VojtaKudela/BPC-DE1-topic_4/Documentation/Schematics/matrix_control.png

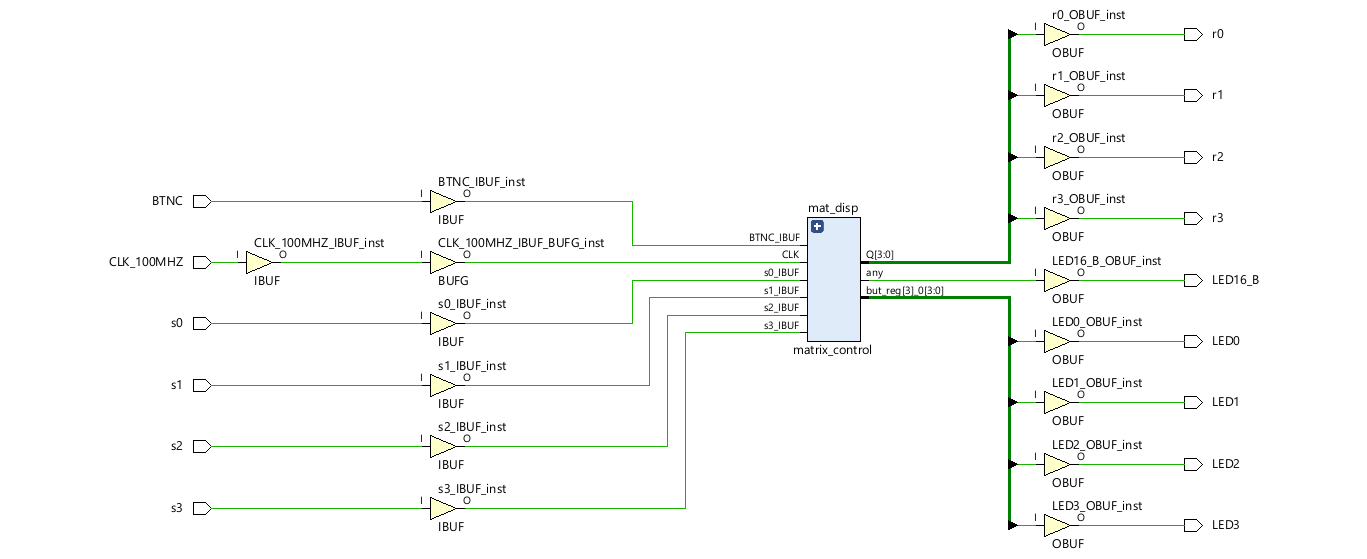
Documentation/Schematics/matrix_control.png
