VojtaKudela/BPC-DE1-topic_4/Picture/ForReadMe/LED.png

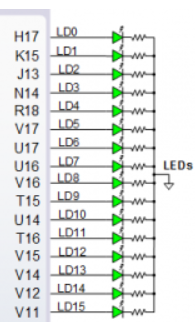
Picture/ForReadMe/LED.png
