VojtaKudela/BPC-DE1-topic_4/Picture/ForReadMe/PWM_mod.png

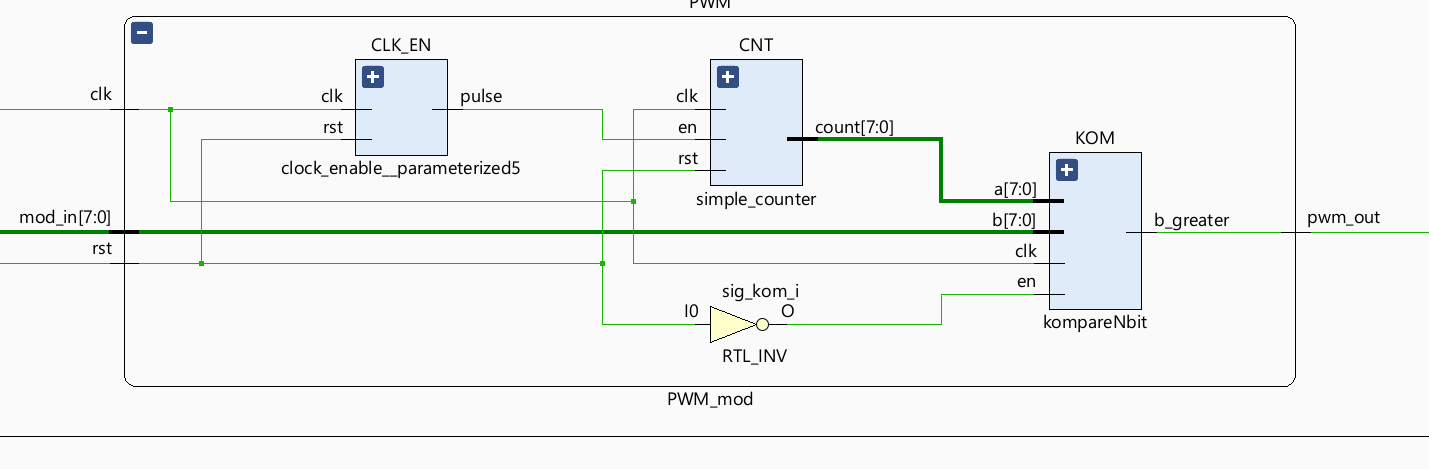
Picture/ForReadMe/PWM_mod.png
