VojtaKudela/BPC-DE1-topic_4/Picture/PředlohyKProgramování/bin2seg_1.jpg

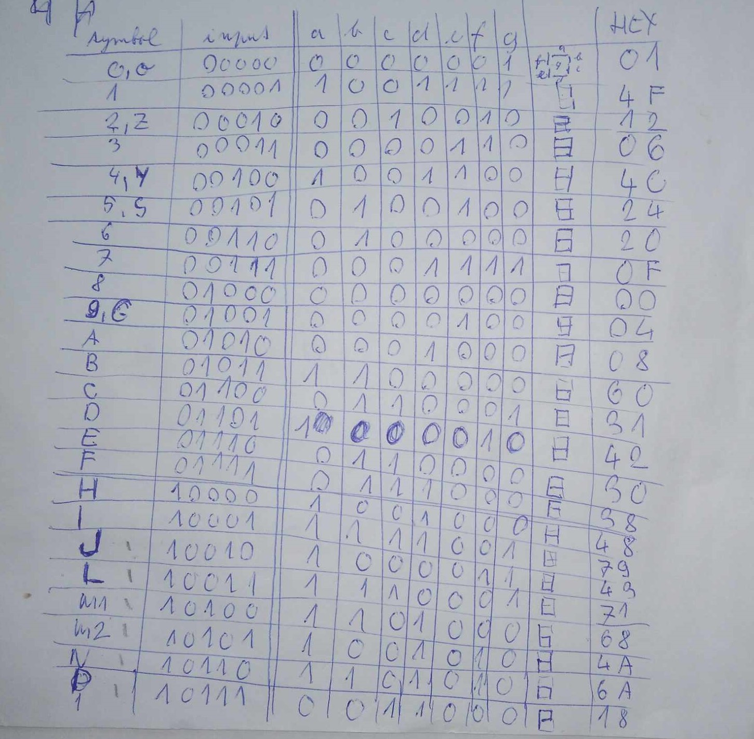
Picture/PředlohyKProgramování/bin2seg_1.jpg
