VojtaKudela/BPC-DE1-topic_4/Picture/PředlohyKProgramování/bin2seg_2.jpg

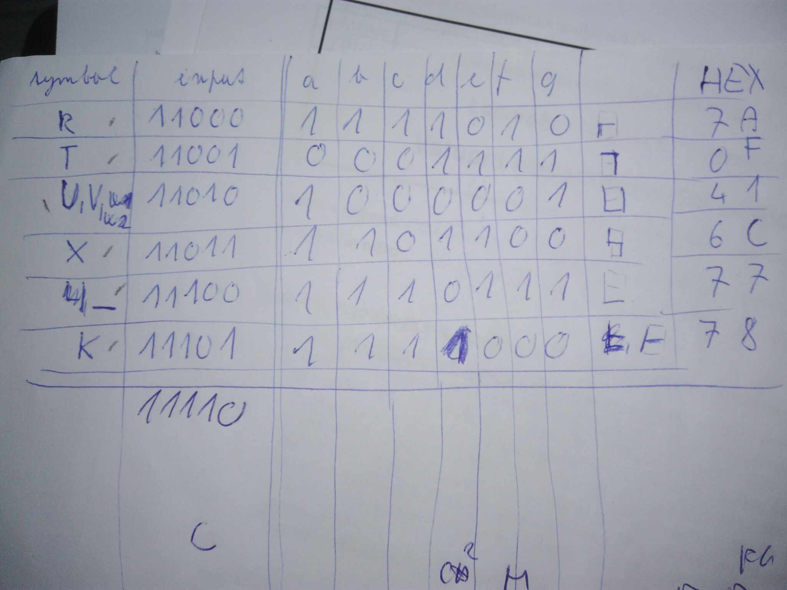
Picture/PředlohyKProgramování/bin2seg_2.jpg
