VojtaKudela/BPC-DE1-topic_4/Picture/PředlohyKProgramování/DispleyControl.jpg

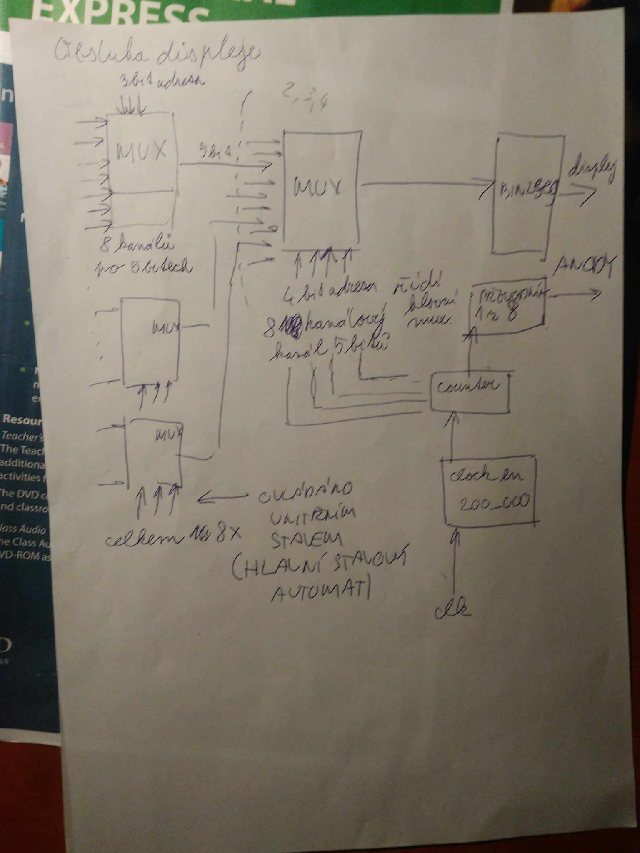
Picture/PředlohyKProgramování/DispleyControl.jpg
