VojtaKudela/BPC-DE1-topic_4/Picture/PředlohyKProgramování/Main_loop_state.jpg

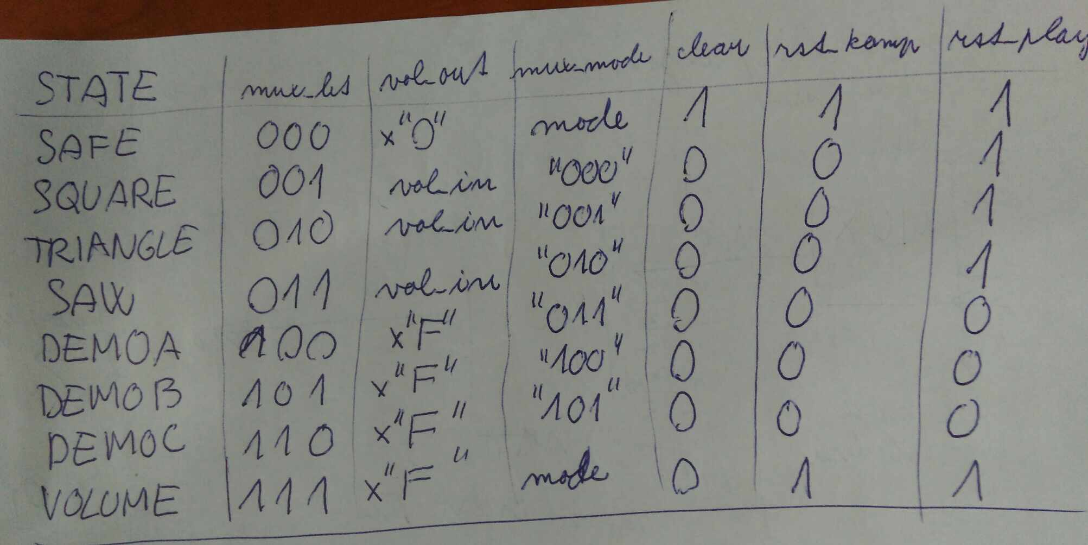
Picture/PředlohyKProgramování/Main_loop_state.jpg
