VojtaKudela/BPC-DE1-topic_4/Picture/PředlohyKProgramování/MaticovyDisplej.jpg

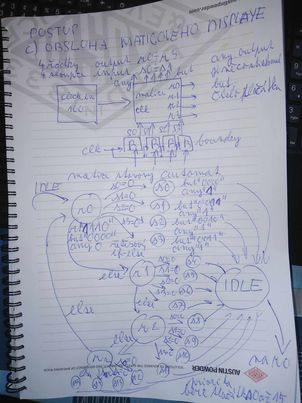
Picture/PředlohyKProgramování/MaticovyDisplej.jpg
