VojtaKudela/BPC-DE1-topic_4/Picture/PředlohyKProgramování/multiplex.jpg

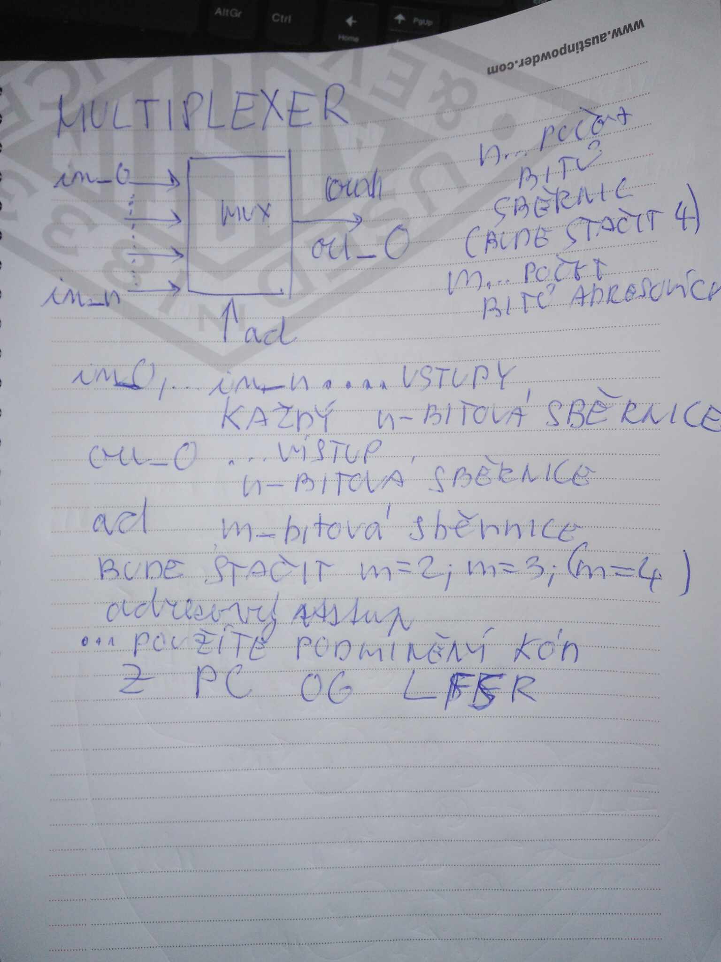
Picture/PředlohyKProgramování/multiplex.jpg
