VojtaKudela/BPC-DE1-topic_4/Picture/PředlohyKProgramování/ObsluhaModu.jpg

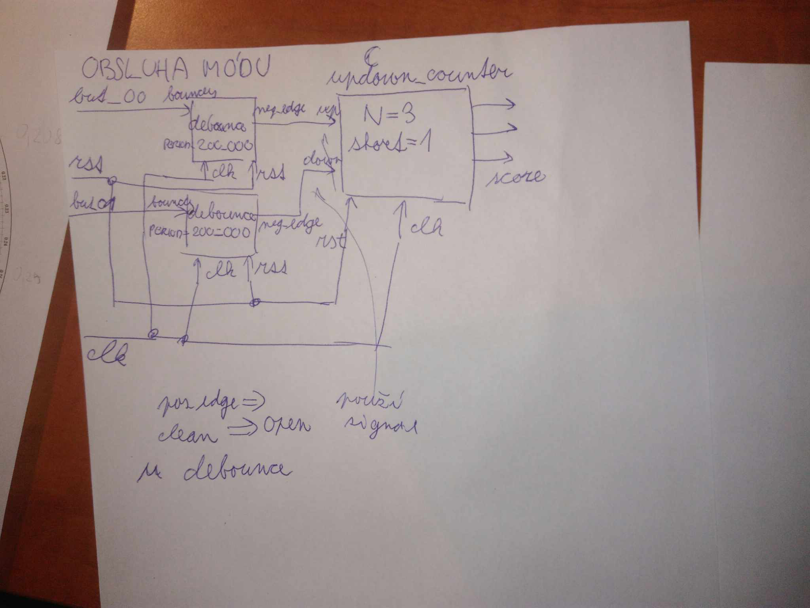
Picture/PředlohyKProgramování/ObsluhaModu.jpg
