VojtaKudela/BPC-DE1-topic_4/Picture/PředlohyKProgramování/Volume.jpg

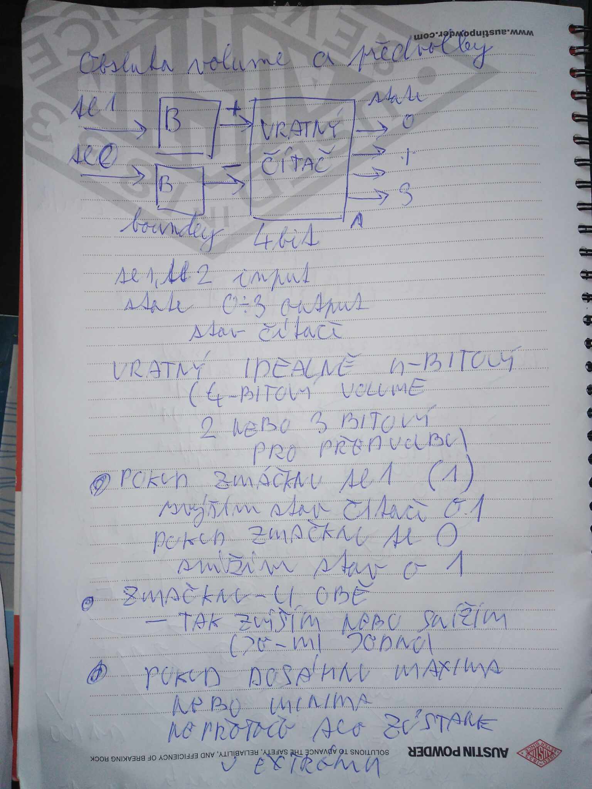
Picture/PředlohyKProgramování/Volume.jpg
