VojtaKudela/BPC-DE1-topic_4/Picture/Sim/NNUM_2.png

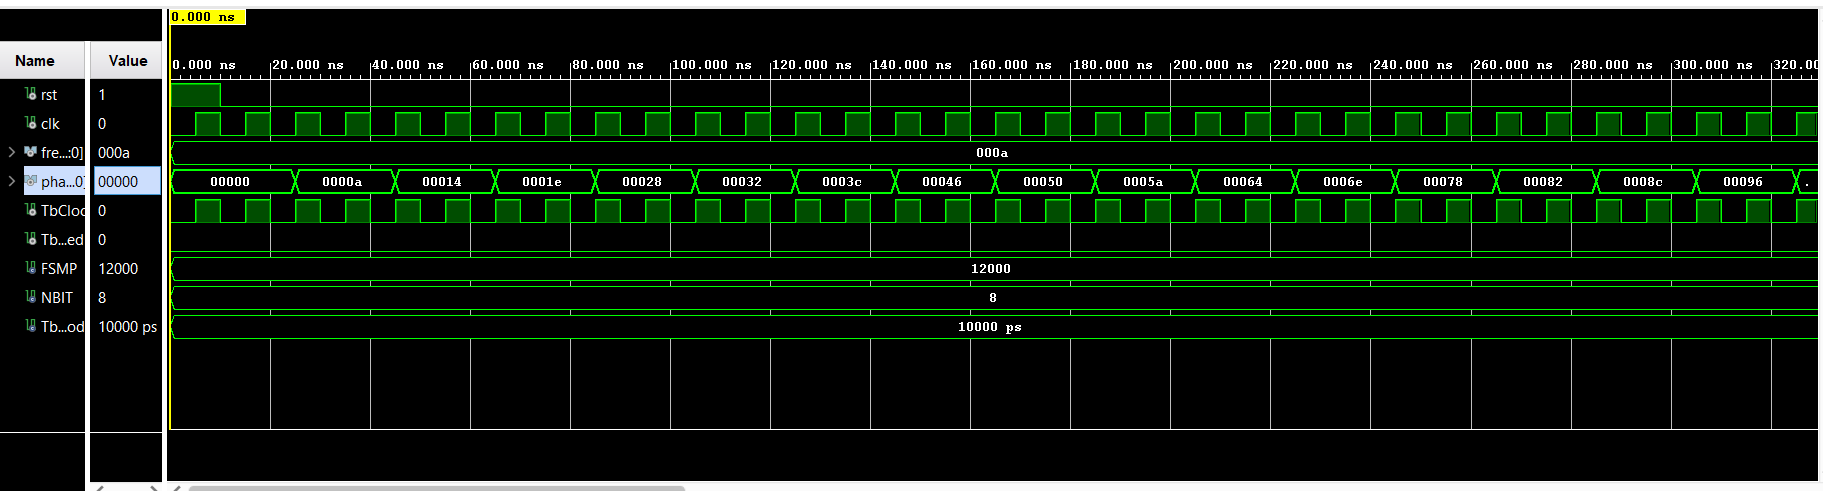
Picture/Sim/NNUM_2.png
