VojtaKudela/BPC-DE1-topic_4/MAIN/Project_PWM.srcs/sources_1/new/demo_ins_1.vhd

----------------------------------------------------------------------------------
-- Company: 
-- Engineer: 
-- 
-- Create Date: 12.04.2024 17:04:10
-- Design Name: 
-- Module Name: demo_ins_1 - Behavioral
-- Project Name: 
-- Target Devices: 
-- Tool Versions: 
-- Description: 
-- 
-- Dependencies: 
-- 
-- Revision:
-- Revision 0.01 - File Created
-- Additional Comments:
-- 
----------------------------------------------------------------------------------


library IEEE;
use IEEE.STD_LOGIC_1164.ALL;

-- Uncomment the following library declaration if using
-- arithmetic functions with Signed or Unsigned values
--use IEEE.NUMERIC_STD.ALL;

-- Uncomment the following library declaration if instantiating
-- any Xilinx leaf cells in this code.
--library UNISIM;
--use UNISIM.VComponents.all;

entity demo_ins_1 is
    Port ( 
           step : in  STD_LOGIC_VECTOR (5 downto 0);
           freq : out STD_LOGIC_VECTOR (3 downto 0);
           vol  : out STD_LOGIC_VECTOR (3 downto 0)
           );
end demo_ins_1;

architecture Behavioral of demo_ins_1 is

begin
    melody_02 : process (step) is -- Do you heard the people sing?
  begin
    
    case step is
         when "000000" =>
            freq <= x"C";
            vol  <= x"0";
            
         when "000001" =>
            freq <= x"C";
            vol  <= x"B";
         
         when "000010" =>
            freq <= x"C";
            vol  <= x"6";
         
         when "000011" =>
            freq <= x"A";
            vol  <= x"C";
         
         when "000100" =>
            freq <= x"8";
            vol  <= x"B";
         
         when "000101" =>
            freq <= x"8";
            vol  <= x"6";
         
         when "000110" =>
            freq <= x"A";
            vol  <= x"C";
         
         when "000111" =>
            freq <= x"C";
            vol  <= x"B";
         
         when "001000" =>
            freq <= x"C";
            vol  <= x"6";
         
         when "001001" =>
            freq <= x"D";
            vol  <= x"C";
         
         when "001010" =>
            freq <= x"F";
            vol  <= x"D";
         
         when "001011" =>
            freq <= x"F";
            vol  <= x"7";
         
         when "001100" =>
            freq <= x"F";
            vol  <= x"0";
        
         when "001101" =>
            freq <= x"C";
            vol  <= x"D";
         
         when "001110" =>
            freq <= x"A";
            vol  <= x"D";
            
         when "001111" =>
            freq <= x"8";
            vol  <= x"D";
            
         when "010000" =>
            freq <= x"7";
            vol  <= x"B";
            
         when "010001" =>
            freq <= x"7";
            vol  <= x"6";
         
         when "010010" =>
            freq <= x"5";
            vol  <= x"C";
         
         when "010011" =>
            freq <= x"7";
            vol  <= x"B";
         
         when "010100" =>
            freq <= x"7";
            vol  <= x"6";
         
         when "010101" =>
            freq <= x"8";
            vol  <= x"C";
         
         when "010110" =>
            freq <= x"3";
            vol  <= x"B";
         
         when "010111" =>
            freq <= x"3";
            vol  <= x"5";
         
         when "011000" =>
            freq <= x"3";
            vol  <= x"0";
         
         when "011001" =>
            freq <= x"5";
            vol  <= x"B";
         
         when "011010" =>
            freq <= x"3";
            vol  <= x"B";
         
         when "011011" =>
            freq <= x"1";
            vol  <= x"B";
         
         when "011100" =>
            freq <= x"0";
            vol  <= x"9";
        
         when "011101" =>
            freq <= x"0";
            vol  <= x"7";
         
         when "011110" =>
            freq <= x"3";
            vol  <= x"B";
            
         when "011111" =>
            freq <= x"8";
            vol  <= x"A";
         
         when "100000" =>
            freq <= x"8";
            vol  <= x"8";
            
         when "100001" =>
            freq <= x"C";
            vol  <= x"C";
         
         when "100010" =>
            freq <= x"A";
            vol  <= x"B";
         
         when "100011" =>
            freq <= x"A";
            vol  <= x"9";
         
         when "100100" =>
            freq <= x"9";
            vol  <= x"7";
         
         when "100101" =>
            freq <= x"A";
            vol  <= x"B";
         
         when "100110" =>
            freq <= x"A";
            vol  <= x"9";
         
         when "100111" =>
            freq <= x"5";
            vol  <= x"D";
         
         when "101000" =>
            freq <= x"8";
            vol  <= x"C";
         
         when "101001" =>
            freq <= x"8";
            vol  <= x"A";
         
         when "101010" =>
            freq <= x"7";
            vol  <= x"D";
         
         when "101011" =>
            freq <= x"7";
            vol  <= x"C";
         
         when "101100" =>
            freq <= x"7";
            vol  <= x"A";
        
         when "101101" =>
            freq <= x"8";
            vol  <= x"F";
         
         when "101110" =>
            freq <= x"A";
            vol  <= x"C";
            
         when "101111" =>
            freq <= x"A";
            vol  <= x"9";
            
         when "110000" =>
            freq <= x"A";
            vol  <= x"6";
            
         when "110001" =>
            freq <= x"A";
            vol  <= x"3";
         
         when "110010" =>
            freq <= x"A";
            vol  <= x"0";
         
         when "110011" =>
            freq <= x"A";
            vol  <= x"0";
         
         when "110100" =>----
            freq <= x"C";
            vol  <= x"B";
         
         when "110101" =>
            freq <= x"C";
            vol  <= x"6";
         
         when "110110" =>
            freq <= x"A";
            vol  <= x"C";
         
         when "110111" =>
            freq <= x"8";
            vol  <= x"B";
         
         when "111000" =>
            freq <= x"8";
            vol  <= x"6";
         
         when "111001" =>
            freq <= x"A";
            vol  <= x"C";
         
         when "111010" =>
            freq <= x"C";
            vol  <= x"B";
         
         when "111011" =>
            freq <= x"C";
            vol  <= x"6";
         
         when "111100" =>
            freq <= x"D";
            vol  <= x"C";
        
         when "111101" =>
            freq <= x"F";
            vol  <= x"D";
         
         when "111110" =>
            freq <= x"F";
            vol  <= x"6";
            
         when others =>
            freq <= x"F";
            vol  <= x"0";
            
    end case;
 end process melody_02;

end Behavioral;
